nbl14/networked-control-system/MATLAB models/Simulations/Speed Control/pole plots/dly3.png

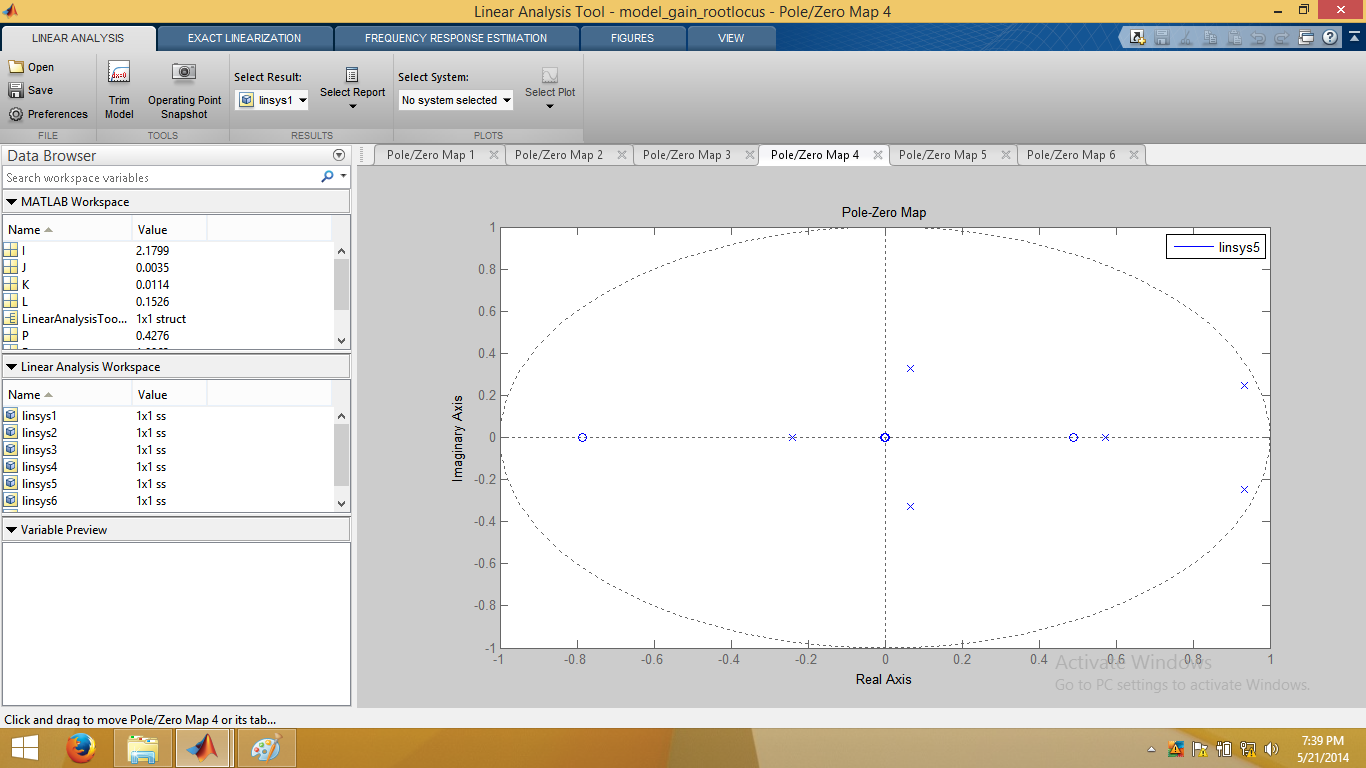
MATLAB models/Simulations/Speed Control/pole plots/dly3.png
