nbl14/networked-control-system/(list of files, drawings)

Other design files:
Hardware design in Proteus/main v11.pdsprj
